darthdaver/Aqua2.O/Remote/CordovaWebApplication/acqua2o/www/assets/ocean.png

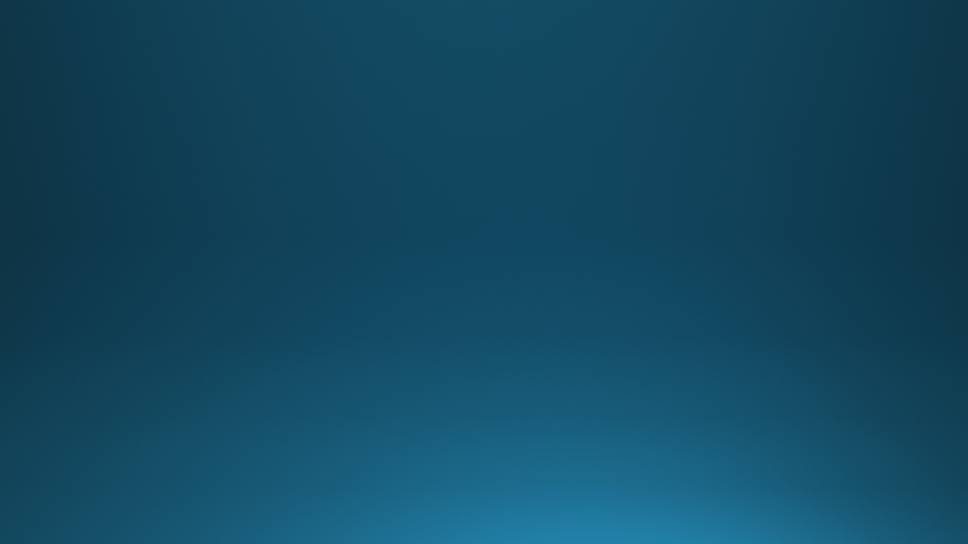
Remote/CordovaWebApplication/acqua2o/www/assets/ocean.png
