darthdaver/Aqua2.O/README.md

Aqua2.O

*******************************************************************************

Report
------
Contains the report of the project.

*******************************************************************************

Data
----
Contains the CSV files with the data that we collected in the the data
acquisition phase.

*******************************************************************************

Acquisition
-----------
Contains the script developed to perform data acquisition with Arduino
microcontroller, to save data on SD card and to send data over the internet
via Wi-Fi connection.

*******************************************************************************

Remote
------
Contains the file used to build a remote system able to store the data sent by
Arduino and to display data in real time.

*******************************************************************************

Analysis
--------
Contains the Matlab files used to perform analysis on the data files.

*******************************************************************************

Presentation
------------
Contains the ppt used in the milestones.

*******************************************************************************

Credits
-------
Davide Molinelli
Emanuele Falzone
